cmu-argus-2/Avionics-Argus3-FOC-Shield/Avionics-RWboard.kicad_pcb

## KiCad design Avionics-RWboard.kicad_pcb (2026-03-17)

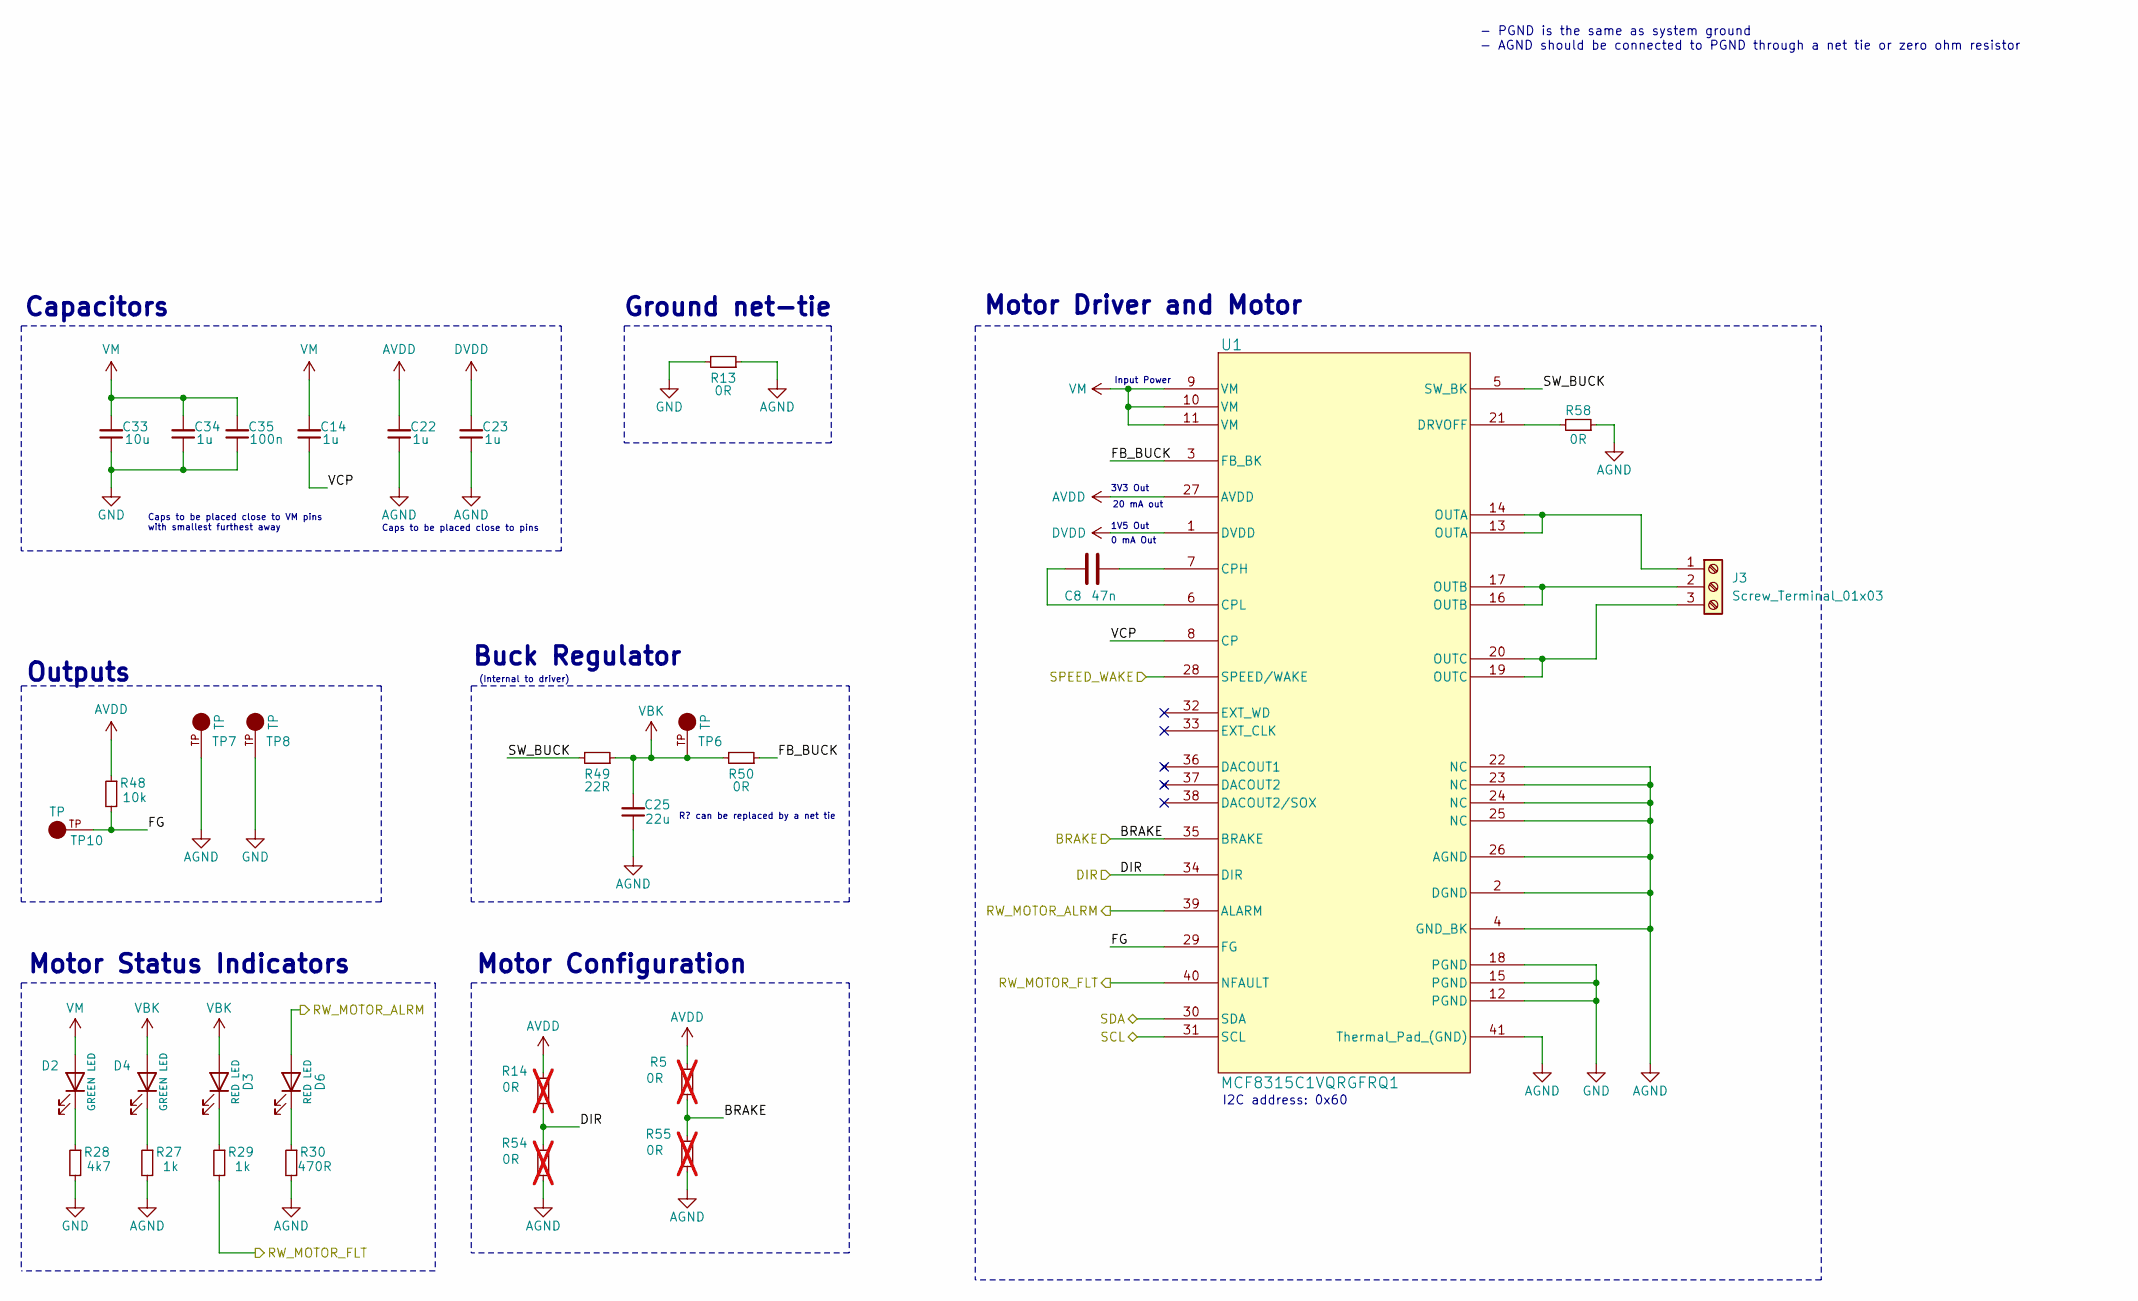
[picture p1: schematic Motor.kicad_sch, Argus Reaction Wheel - Nucleo Shield]

Parts:
C8: 47n; C_0603_1608Metric; Part GCM188R71H473KA55D; Digikey PN 490-4934-1-ND
C14, C22, C23, C34: 1u; C_0603_1608Metric; Part CL10B105KA8NNNC; Digikey PN 1276-1184-1-ND
C25: 22u; C_0603_1608Metric; MPN CL10A226MP8NUNE; Digikey PN 1276-1274-1-ND
C33: 10u; C_1206_3216Metric_Pad1.33x1.80mm_HandSolder; Part CL31B106KAHNNNE; Digikey PN 1276-1804-1-ND
C35: 100n; C_0603_1608Metric; Part C0402C103K3RACTU; Digikey PN 399-C0402C103K3RACTUCT-ND
D2, D4: GREEN LED; LED_0603_1608Metric; Manufacturer_Part_Number LTST-C190KGKT; Digikey PN 1830-1064-1-ND
D3, D6: RED LED; LED_0603_1608Metric; Manufacturer_Part_Number LTST-C190KRKT; Digikey PN 1830-1065-1-ND
J3: Screw_Terminal_01x03; TerminalBlock_Phoenix_MKDS-1,5-3_1x03_P5.00mm_Horizontal
R5, R14, R54, R55: 0R; R_0603_1608Metric; MPN RC0402JR-070RL; Digikey PN 311-0.0JRCT-ND; not fitted
R13, R50: 0R; R_0805_2012Metric_Pad1.20x1.40mm_HandSolder; MPN RC0805JR-070RL; Digikey PN 311-0.0ARCT-ND
R27, R29: 1k; R_0603_1608Metric; MPN RC0603FR-071KL; Digikey PN 311-1.00KHRCT-ND
R28: 4k7; R_0603_1608Metric; MPN RC0603FR-074K7L; Digikey PN 311-4.70KHRCT-ND
R30: 470R; R_0603_1608Metric; MPN RC0603FR-13470RL; Digikey PN 13-RC0603FR-13470RLCT-ND
R48: 10k; R_0603_1608Metric; MPN RC0603FR-0710KL; Digikey PN 311-10.0KHRCT-ND
R49: 22R; R_2512_6332Metric_Pad1.40x3.35mm_HandSolder; Part CRCW251222R0FKEGHP; Digikey PN 541-CRCW251222R0FKEGHPCT-ND
R58: 0R; R_0603_1608Metric; MPN RC0402JR-070RL; Digikey PN 311-0.0JRCT-ND
TP6, TP7, TP8, TP10: TP; KEYSTONE_5001; MPN 5001; Digikey PN 36-5001-ND
U1: MCF8315C1VQRGFRQ1; VQFN40_RGF_TEX; MPN MCF8315C1VQRGFRQ1; Digikey PN 296-MCF8315C1VQRGFRQ1CT-ND

Connections:
/Connectors/RW_MOTOR_ALRM: D6.2 (A), U1.39 (ALARM); also elsewhere on the board
/Connectors/RW_MOTOR_FLT: R29.2, U1.40 (NFAULT); also elsewhere on the board
/Connectors/SCL: U1.31 (SCL); also elsewhere on the board
/Connectors/SDA: U1.30 (SDA); also elsewhere on the board
/Connectors/SPEED_WAKE: U1.28 (SPEED/WAKE); also elsewhere on the board
/Motor/BRAKE: R5.1, R55.2, U1.35 (BRAKE); also elsewhere on the board
/Motor/DIR: R14.1, R54.2, U1.34 (DIR); also elsewhere on the board
/Motor/FB_BUCK: R50.1, U1.3 (FB_BK)
/Motor/FG: R48.2, TP10.TP, U1.29 (FG)
/Motor/SW_BUCK: R49.2, U1.5 (SW_BK)
/Motor/VCP: C14.1, U1.8 (CP)
AGND: C22.1, C23.1, C25.1, R13.1, R27.2, R30.2, R54.1, R55.1, R58.1, TP7.TP, U1.2 (DGND), U1.4 (GND_BK), U1.22 (NC), U1.23 (NC), U1.24 (NC), U1.25 (NC), U1.26 (AGND), U1.41 (Thermal_Pad_(GND))
AVDD: C22.2, R5.2, R14.2, R48.1, U1.27 (AVDD)
DVDD: C23.2, U1.1 (DVDD)
GND: C33.1, C34.1, C35.1, R13.2, R28.2, TP8.TP, U1.12 (PGND), U1.15 (PGND), U1.18 (PGND); also elsewhere on the board
unnamed: D2.1 (K), R28.1
unnamed: D3.1 (K), R29.1
unnamed: D4.1 (K), R27.1
unnamed: D6.1 (K), R30.1
unnamed: J3.1, U1.13 (OUTA), U1.14 (OUTA)
unnamed: J3.2, U1.16 (OUTB), U1.17 (OUTB)
unnamed: J3.3, U1.19 (OUTC), U1.20 (OUTC)
unnamed: C8.1, U1.7 (CPH)
unnamed: C8.2, U1.6 (CPL)
unnamed: R58.2, U1.21 (DRVOFF)
VBK: C25.2, D3.2 (A), D4.2 (A), R49.1, R50.2, TP6.TP
VM: C14.2, C33.2, C34.2, C35.2, D2.2 (A), U1.9 (VM), U1.10 (VM), U1.11 (VM); also elsewhere on the board

Notes on the sheet:
20 mA out
3V3 Out
Caps to be placed close to pins
Buck Regulator
0 mA Out
R? can be replaced by a net tie
Input Power
I2C address: 0x60
Motor Driver and Motor
Caps to be placed close to VM pins with smallest furthest away
Ground net-tie
Outputs
1V5 Out
Motor Configuration
- PGND is the same as system ground - AGND should be connected to PGND through a net tie or zero ohm resistor
(Internal to driver)
Motor Status Indicators
Capacitors

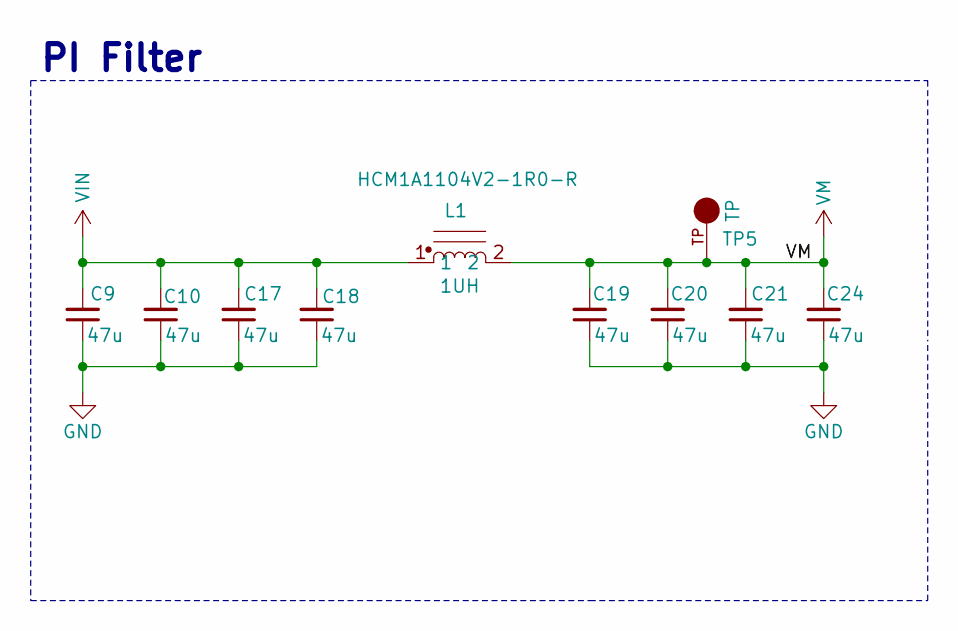
[picture p2: schematic Power.kicad_sch, Argus Reaction Wheel - Nucleo Shield]

Parts:
C9, C10, C17, C18, C19, C20, C21, C24: 47u; C_1206_3216Metric_Pad1.33x1.80mm_HandSolder; Part C3216X5R1E476M160AC; Digikey PN 445-8047-1-ND
L1: 1UH; HCM1A1104V2; Part HCM1A1104V2-1R0-R; Digikey PN 283-HCM1A1104V2-1R0-RCT-ND
TP5: TP; KEYSTONE_5001; MPN 5001; Digikey PN 36-5001-ND

Connections:
GND: C9.1, C10.1, C17.1, C18.1, C19.1, C20.1, C21.1, C24.1; also elsewhere on the board
VIN: C9.2, C10.2, C17.2, C18.2, L1.1; also elsewhere on the board
VM: C19.2, C20.2, C21.2, C24.2, L1.2, TP5.TP; also elsewhere on the board

Notes on the sheet:
PI Filter

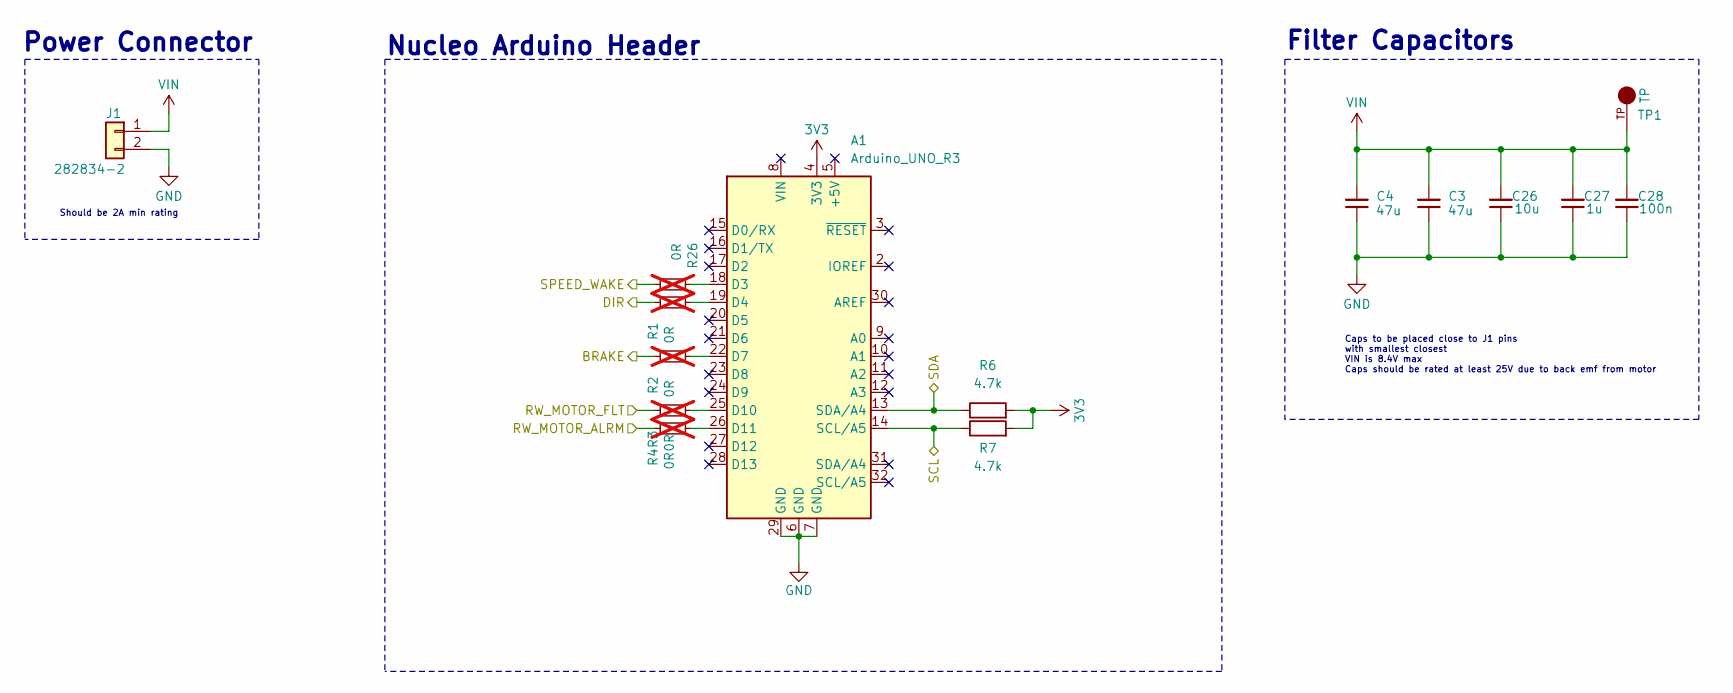
[picture p3: schematic Connectors.kicad_sch, Argus Reaction Wheel - Nucleo Shield]

Parts:
A1: Arduino_UNO_R3
C3, C4: 47u; C_1206_3216Metric_Pad1.33x1.80mm_HandSolder; Part C3216X5R1E476M160AC; Digikey PN 445-8047-1-ND
C26: 10u; C_1206_3216Metric_Pad1.33x1.80mm_HandSolder; Part CL31B106KAHNNNE; Digikey PN 1276-1804-1-ND
C27: 1u; C_0603_1608Metric; Part CL10B105KA8NNNC; Digikey PN 1276-1184-1-ND
C28: 100n; C_0603_1608Metric; Part C0402C103K3RACTU; Digikey PN 399-C0402C103K3RACTUCT-ND
J1: 282834-2; TE_282834-2; MPN 282834-2; Digikey PN A98333-ND
R1, R2, R3, R4, R26: 0R; R_0603_1608Metric; MPN RC0402JR-070RL; Digikey PN 311-0.0JRCT-ND; not fitted
R6, R7: 4.7k; R_0603_1608Metric
TP1: TP; KEYSTONE_5001; MPN 5001; Digikey PN 36-5001-ND

Connections:
3V3: A1.4 (3V3), R6.2, R7.2
/Connectors/RW_MOTOR_ALRM: R4.2; also elsewhere on the board
/Connectors/RW_MOTOR_FLT: R3.2; also elsewhere on the board
/Connectors/SCL: A1.14 (SCL/A5), R7.1; also elsewhere on the board
/Connectors/SDA: A1.13 (SDA/A4), R6.1; also elsewhere on the board
/Connectors/SPEED_WAKE: R26.1; also elsewhere on the board
/Motor/BRAKE: R2.2; also elsewhere on the board
/Motor/DIR: R1.2; also elsewhere on the board
GND: A1.6 (GND), A1.7 (GND), A1.29 (GND), C3.1, C4.1, C26.1, C27.1, C28.1, J1.2; also elsewhere on the board
unnamed: A1.18 (D3), R26.2
unnamed: A1.19 (D4), R1.1
unnamed: A1.22 (D7), R2.1
unnamed: A1.25 (D10), R3.1
unnamed: A1.26 (D11), R4.1
VIN: C3.2, C4.2, C26.2, C27.2, C28.2, J1.1, TP1.TP; also elsewhere on the board

Notes on the sheet:
Filter Capacitors
Caps to be placed close to J1 pins with smallest closest VIN is 8.4V max Caps should be rated at least 25V due to back emf from motor
Should be 2A min rating
Power Connector
Nucleo Arduino Header

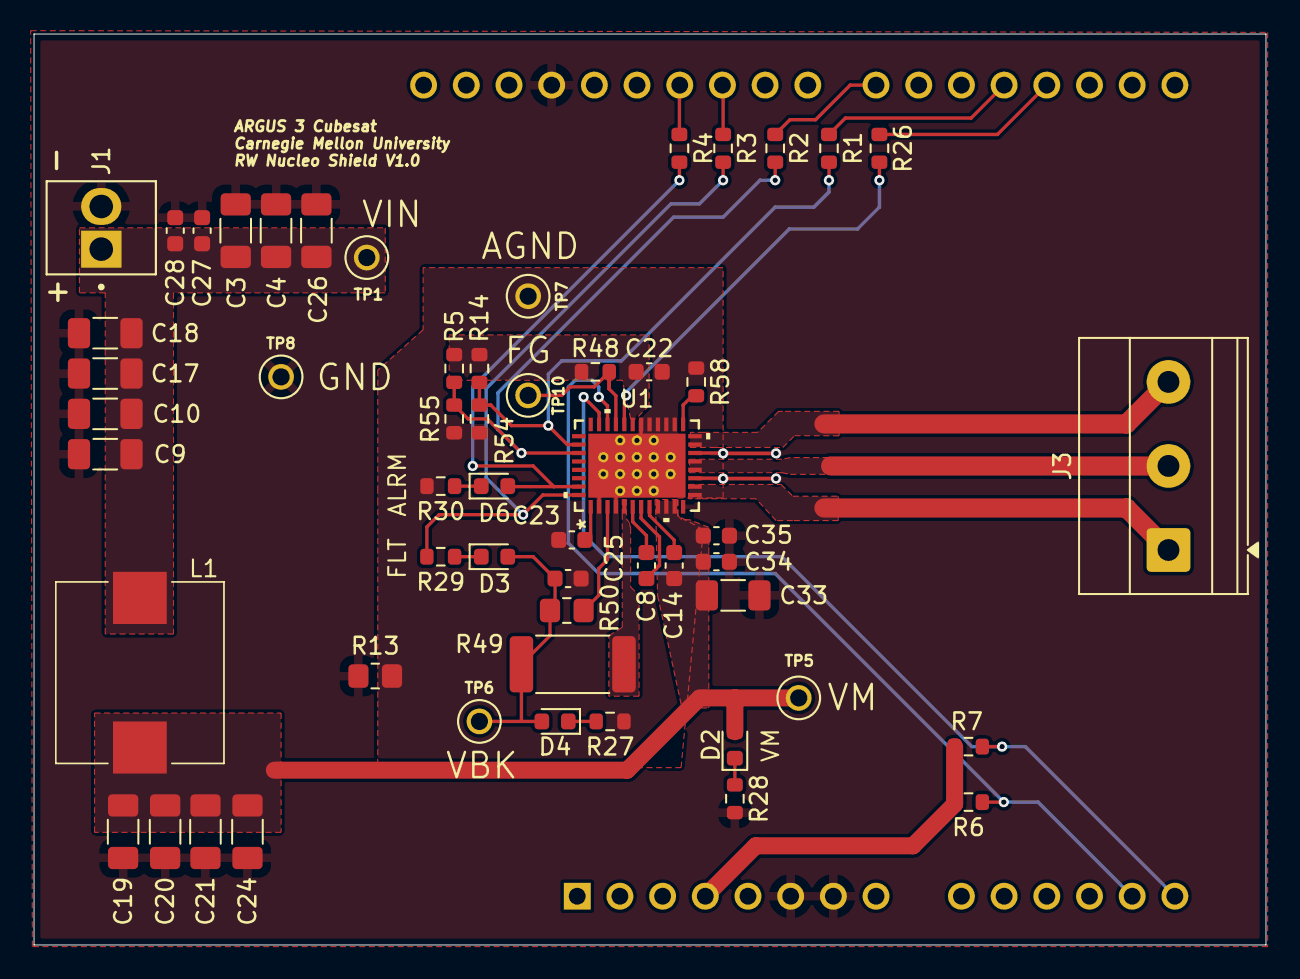
[picture p4: board Avionics-RWboard.kicad_pcb from above]

Board: 2 copper layers, 73.3 x 54.2 mm, 56 parts (1 on the bottom side), 34 nets.
