cmu-argus-2/Avionics-Argus3-FOC-Shield/(commit log)

2026-03-11 fix KiCad-Libraries as submodule
    [0806.step, 104031-0811.step, 1042.step, 1048.step, 1393219-4.stp, 1715747.step, 1823638.stp, 1824543.stp]
2026-03-17 moved inductor and added leds
    [Avionics-RWboard.kicad_pcb, Avionics-RWboard.kicad_sch, Connectors.kicad_sch, Motor.kicad_sch, Power.kicad_sch]
2026-03-17 finished board
    [Avionics-RWboard.kicad_pcb, Connectors.kicad_sch, Motor.kicad_sch]
2026-03-17 added bom
    [Avionics-RWboard.kicad_pcb]
